mvvproject/ReVerSE-U8/u8_tsconf/readme.txt

-------------------------------------------------------------------------------
U8-TSConf
DEVBOARD ReVerSE-U8 By MVV
-------------------------------------------------------------------------------
27.07.2014	первая версия
03.07.2014	перенос с ReVerSE-U16
05.07.2014	доработка keyboard.vhd для работы с WC, I2S, Mouse
09.09.2014	добавлена поддержка IDE Video DAC (3:3:3) (zports.v, video_out.v, lut.vhd)
21.09.2014	tv80s вместо t80 (биения бордюрных эффектов)
25.07.2015	в загрузчике добавлена загрузка ROMS/ZXEVO.ROM с SD Card FAT32
04.10.2015	доработка sdram.vhd для U8 (автор shurik-ua)
29.01.2017	добавлена SAA1099, замена YM2149
