mvvproject/ReVerSE-U8/u8_board/images/u8_bot01.jpg

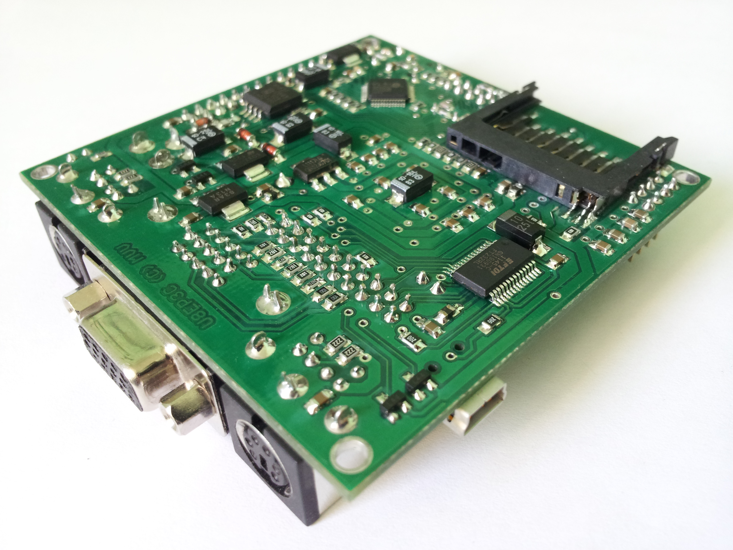
u8_board/images/u8_bot01.jpg
