mvvproject/ReVerSE-U8/u8_board/images/u8_top01.jpg

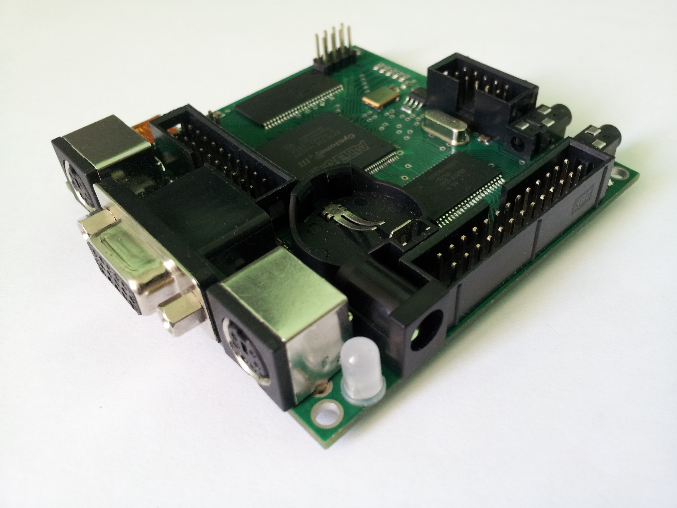
u8_board/images/u8_top01.jpg
