mvvproject/ReVerSE-U8/(list of files, cad)

Other CAD files:
u8_speccy/boards/reverse_u9/syn/stp1.stp
