mvvproject/ReVerSE-U8/u8_tsconf/rtl/gs/gs.vhd

-------------------------------------------------------------------[04.10.2015]
-- General Sound
-------------------------------------------------------------------------------
-- 01.11.2011	первая версия
-- 19.12.2011	CPU @ 84MHz, подтверждение INT#
-- 10.05.2013	исправлен bit7_flag, bit0_flag
-- 29.05.2013	добавлена громкость каналов, CPU @ 21MHz
-- 21.07.2013	исправлен int_n

-- CPU: Z80
-- ROM: 32K
-- RAM: 480K
-- INT: 37.5KHz

-- #xxBB Command register - регистр команд, доступный для записи
-- #xxBB Status register - регистр состояния, доступный для чтения
--		bit 7 флаг данных
--		bit <6:1> Не определен
--		bit 0 флаг команд. Этот регистр позволяет определить состояние GS, в частности можно ли прочитать или записать очередной байт данных, или подать очередную команду, и т.п.
-- #xxB3 Data register - регистр данных, доступный для записи. В этот регистр Спектрум записывает данные, например, это могут быть аргументы команд.
-- #xxB3 Output register - регистр вывода, доступный для чтения. Из этого регистра Спектрум читает данные, идущие от GS

-- Внутренние порта:
-- #xx00 "расширенная память" - регистр доступный для записи
--		bit <3:0> переключают страницы по 32Kb, страница 0 - ПЗУ
--		bit <7:0> не используются

-- порты 1 - 5 "обеспечивают связь с SPECTRUM'ом"
-- #xx01 чтение команды General Sound'ом
--		bit <7:0> код команды
-- #xx02 чтение данных General Sound'ом
--		bit <7:0> данные
-- #xx03 запись данных General Sound'ом для SPECTRUM'a
--		bit <7:0> данные
-- #xx04 чтение слова состояния General Sound'ом
--		bit 0 флаг команд
--		bit 7 флаг данных
-- #xx05 сбрасывает бит D0 (флаг команд) слова состояния

-- порты 6 - 9 "регулировка громкости" в каналах 1 - 4
-- #xx06 "регулировка громкости" в канале 1
--		bit <5:0> громкость
--		bit <7:6> не используются
-- #xx07 "регулировка громкости" в канале 2
--		bit <5:0> громкость
--		bit <7:6> не используются
-- #xx08 "регулировка громкости" в канале 3
--		bit <5:0> громкость
--		bit <7:6> не используются
-- #xx09 "регулировка громкости" в канале 4
--		bit <5:0> громкость
--		bit <7:6> не используются

-- #xx0A устанавливает бит 7 слова состояния не равным биту 0 порта #xx00
-- #xx0B устанавливает бит 0 слова состояния равным биту 5 порта #xx06

--Распределение памяти
--#0000 - #3FFF  -  первые 16Kb ПЗУ
--#4000 - #7FFF  -  первые 16Kb первой страницы ОЗУ
--#8000 - #FFFF  -  листаемые страницы по 32Kb
--                  страница 0  - ПЗУ,
--                  страница 1  - первая страница ОЗУ
--                  страницы 2... ОЗУ

--Данные в каналы заносятся при чтении процессором ОЗУ по адресам  #6000 - #7FFF автоматически.

library IEEE; 
use IEEE.std_logic_1164.all; 
use IEEE.std_logic_unsigned.all;
use IEEE.numeric_std.all;
use IEEE.STD_LOGIC_ARITH.all;

entity gs is
	Port ( 
		RESET		: in std_logic;
		CLK			: in std_logic;
		CLKGS		: in std_logic;
		A			: in std_logic_vector(15 downto 0);
		DI			: in std_logic_vector(7 downto 0);
		DO			: out std_logic_vector(7 downto 0);
		WR_n		: in std_logic;
		RD_n		: in std_logic;
		IORQ_n		: in std_logic;
		M1_n		: in std_logic;
		OUTA		: out std_logic_vector(13 downto 0);
		OUTB		: out std_logic_vector(13 downto 0);
		OUTC		: out std_logic_vector(13 downto 0);
		OUTD		: out std_logic_vector(13 downto 0);
		MA			: out std_logic_vector(18 downto 0);
		MDI			: in std_logic_vector(7 downto 0);
		MDO			: out std_logic_vector(7 downto 0);
		MWE_n		: out std_logic);
end gs;
 
architecture gs_unit of gs is
	signal port_xxbb_reg	: std_logic_vector(7 downto 0);
	signal port_xxb3_reg 	: std_logic_vector(7 downto 0);
	signal port_xx00_reg 	: std_logic_vector(7 downto 0);
	signal port_xx03_reg 	: std_logic_vector(7 downto 0);
	signal port_xx06_reg 	: std_logic_vector(5 downto 0);
	signal port_xx07_reg 	: std_logic_vector(5 downto 0);
	signal port_xx08_reg 	: std_logic_vector(5 downto 0);
	signal port_xx09_reg 	: std_logic_vector(5 downto 0);
	signal ch_a_reg 		: std_logic_vector(7 downto 0);
	signal ch_b_reg 		: std_logic_vector(7 downto 0);
	signal ch_c_reg 		: std_logic_vector(7 downto 0);
	signal ch_d_reg 		: std_logic_vector(7 downto 0);
	signal bit7_flag		: std_logic;
	signal bit0_flag		: std_logic;
	signal cnt				: std_logic_vector(9 downto 0);
	signal int_n			: std_logic;
	signal mem				: std_logic_vector(4 downto 0);
	signal out_a			: std_logic_vector(13 downto 0);
	signal out_b			: std_logic_vector(13 downto 0);
	signal out_c			: std_logic_vector(13 downto 0);
	signal out_d			: std_logic_vector(13 downto 0);
	
	-- CPU
	signal cpu_m1_n			: std_logic;
	signal cpu_mreq_n		: std_logic;
	signal cpu_iorq_n		: std_logic;
	signal cpu_rd_n			: std_logic;
	signal cpu_wr_n			: std_logic;
	signal cpu_a_bus		: std_logic_vector(15 downto 0);
	signal cpu_di_bus		: std_logic_vector(7 downto 0);
	signal cpu_do_bus		: std_logic_vector(7 downto 0);

begin

z80_unit: entity work.T80s
generic map (
	Mode			=> 0,	-- 0 => Z80, 1 => Fast Z80, 2 => 8080, 3 => GB
	T2Write			=> 1,	-- 0 => WR_n active in T3, 1 => WR_n active in T2
	IOWait			=> 1)	-- 0 => Single cycle I/O, 1 => Std I/O cycle
port map (
	RESET_n			=> not RESET,
	CLK_n			=> not CLKGS,
	WAIT_n			=> '1',
	INT_n			=> int_n,
	NMI_n			=> '1',
	BUSRQ_n			=> '1',
	M1_n			=> cpu_m1_n,
	MREQ_n			=> cpu_mreq_n,
	IORQ_n			=> cpu_iorq_n,
	RD_n			=> cpu_rd_n,
	WR_n			=> cpu_wr_n,
	RFSH_n			=> open,
	HALT_n			=> open,
	BUSAK_n			=> open,
	A			=> cpu_a_bus,
	DI			=> cpu_di_bus,
	DO			=> cpu_do_bus,
	SavePC      		=> open,
	SaveINT     		=> open,
	RestorePC   		=> (others => '1'),
	RestoreINT  		=> (others => '1'),
	RestorePC_n 		=> '1');

	
process (CLKGS, cnt)
begin
	if CLKGS'event and CLKGS = '1' then
		cnt <= cnt + 1;
		if cnt = "1000110000" then	-- 21MHz / 560 = 0.0375MHz = 37.5kHz
			cnt <= (others => '0');
		end if;
	end if;
end process;

-- INT#
process (CLKGS, cpu_iorq_n, cpu_m1_n, cnt)
begin
	if cpu_iorq_n = '0' and cpu_m1_n = '0' then
		int_n <= '1';
	elsif CLKGS'event and CLKGS = '1' then
		if cnt = "1000110000" then
			int_n <= '0';
		end if;
	end if;
end process;

process (CLKGS, cpu_iorq_n, cpu_m1_n, cpu_a_bus, IORQ_n, RD_n, A, WR_n)
begin
	if (cpu_iorq_n = '0' and cpu_m1_n = '1' and cpu_a_bus(3 downto 0) = X"2") or (IORQ_n = '0' and RD_n = '0' and A(7 downto 0) = X"B3") then
		bit7_flag <= '0';
	elsif (cpu_iorq_n = '0' and cpu_m1_n = '1' and cpu_a_bus(3 downto 0) = X"3") or (IORQ_n = '0' and WR_n = '0' and A(7 downto 0) = X"B3") then
		bit7_flag <= '1';
	elsif CLKGS'event and CLKGS = '1' then
		if (cpu_iorq_n = '0' and cpu_m1_n = '1' and cpu_a_bus(3 downto 0) = X"A") then
			bit7_flag <= not port_xx00_reg(0);
		end if;
	end if;
end process;

process (CLKGS, cpu_iorq_n, cpu_m1_n, cpu_a_bus, IORQ_n, RD_n, A, WR_n)
begin
	if cpu_iorq_n = '0' and cpu_m1_n = '1' and cpu_a_bus(3 downto 0) = X"5" then
		bit0_flag <= '0';
	elsif IORQ_n = '0' and WR_n = '0' and A(7 downto 0) = X"BB" then
		bit0_flag <= '1';
	elsif CLKGS'event and CLKGS = '1' then
		if (cpu_iorq_n = '0' and cpu_m1_n = '1' and cpu_a_bus(3 downto 0) = X"B") then
			bit0_flag <= port_xx06_reg(5);
		end if;
	end if;
end process;

process (CLK, A, IORQ_n, WR_n, RESET)
begin
	-- запись со стороны спектрума
 	if RESET = '1' then
		port_xxbb_reg <= (others => '0');
		port_xxb3_reg <= (others => '0');
	elsif CLK'event and CLK = '1' then
		if IORQ_n = '0' and WR_n = '0' and A(7 downto 0) = X"BB" then port_xxbb_reg <= DI; end if;
		if IORQ_n = '0' and WR_n = '0' and A(7 downto 0) = X"B3" then port_xxb3_reg <= DI; end if;
	end if;
end process;

process (A, bit7_flag, bit0_flag, port_xx03_reg)
begin	
	-- чтение со стороны спектрума
	if A(3) = '1' then	-- port #xxBB
		DO <= bit7_flag & "111111" & bit0_flag;
	else				-- port #xxB3
		DO <= port_xx03_reg;
	end if;
end process;

process (CLKGS, RESET, cpu_a_bus, cpu_m1_n, port_xx00_reg)
begin
	if RESET = '1' then
		port_xx00_reg <= (others => '0');
        port_xx03_reg <= (others => '0');
        port_xx06_reg <= (others => '0');
        port_xx07_reg <= (others => '0');
        port_xx08_reg <= (others => '0');
        port_xx09_reg <= (others => '0');
		ch_a_reg <= (others => '0');
		ch_b_reg <= (others => '0');
		ch_c_reg <= (others => '0');
		ch_d_reg <= (others => '0');
		
	elsif CLKGS'event and CLKGS = '1' then
		if cpu_iorq_n = '0' and cpu_wr_n = '0' and cpu_a_bus(3 downto 0) = X"0" then port_xx00_reg <= cpu_do_bus; end if;
		if cpu_iorq_n = '0' and cpu_wr_n = '0' and cpu_a_bus(3 downto 0) = X"3" then port_xx03_reg <= cpu_do_bus; end if;
		if cpu_iorq_n = '0' and cpu_wr_n = '0' and cpu_a_bus(3 downto 0) = X"6" then port_xx06_reg <= cpu_do_bus(5 downto 0); end if;
		if cpu_iorq_n = '0' and cpu_wr_n = '0' and cpu_a_bus(3 downto 0) = X"7" then port_xx07_reg <= cpu_do_bus(5 downto 0); end if;
		if cpu_iorq_n = '0' and cpu_wr_n = '0' and cpu_a_bus(3 downto 0) = X"8" then port_xx08_reg <= cpu_do_bus(5 downto 0); end if;
		if cpu_iorq_n = '0' and cpu_wr_n = '0' and cpu_a_bus(3 downto 0) = X"9" then port_xx09_reg <= cpu_do_bus(5 downto 0); end if;
		
		if cpu_mreq_n = '0' and cpu_rd_n = '0' and cpu_a_bus(15 downto 13) = "011" and cpu_a_bus(9 downto 8) = "00" then ch_a_reg <= MDI; end if;
		if cpu_mreq_n = '0' and cpu_rd_n = '0' and cpu_a_bus(15 downto 13) = "011" and cpu_a_bus(9 downto 8) = "01" then ch_b_reg <= MDI; end if;
		if cpu_mreq_n = '0' and cpu_rd_n = '0' and cpu_a_bus(15 downto 13) = "011" and cpu_a_bus(9 downto 8) = "10" then ch_c_reg <= MDI; end if;
		if cpu_mreq_n = '0' and cpu_rd_n = '0' and cpu_a_bus(15 downto 13) = "011" and cpu_a_bus(9 downto 8) = "11" then ch_d_reg <= MDI; end if;
	end if;

	case cpu_a_bus(15 downto 14) is
		when "00" => mem <= "00000";										--#0000 - #3FFF  -  первые 16Kb ПЗУ
		when "01" => mem <= "00010";										--#4000 - #7FFF  -  первые 16Kb первой страницы ОЗУ
		when others => mem <= port_xx00_reg(3 downto 0) & cpu_a_bus(14);	--#8000 - #FFFF  -  листаемые страницы по 32Kb
	end case;
end process;

-- Шина данных CPU
cpu_di_bus <=	MDI when (cpu_mreq_n = '0' and cpu_rd_n = '0') else
				bit7_flag & "111111" & bit0_flag when (cpu_iorq_n = '0' and cpu_rd_n = '0' and cpu_a_bus(3 downto 0) = X"4") else
				port_xxbb_reg when (cpu_iorq_n = '0' and cpu_rd_n = '0' and cpu_a_bus(3 downto 0) = X"1") else
				port_xxb3_reg when (cpu_iorq_n = '0' and cpu_rd_n = '0' and cpu_a_bus(3 downto 0) = X"2") else
				"11111111";

OUTA 	<= ch_a_reg * port_xx06_reg;
OUTB 	<= ch_b_reg * port_xx07_reg;
OUTC 	<= ch_c_reg * port_xx08_reg;
OUTD 	<= ch_d_reg * port_xx09_reg;
MA		<= mem & cpu_a_bus(13 downto 0);
MDO 	<= cpu_do_bus;
MWE_n 	<= cpu_wr_n or cpu_mreq_n or not (mem(4) or mem(3) or mem(2) or mem(1));

end gs_unit;
