mvvproject/ReVerSE-U8/u8_msx/src/DE0/SEG7_LUT.V

//Legal Notice: (C)2006 Altera Corporation. All rights reserved. Your
//use of Altera Corporation's design tools, logic functions and other
//software and tools, and its AMPP partner logic functions, and any
//output files any of the foregoing (including device programming or
//simulation files), and any associated documentation or information are
//expressly subject to the terms and conditions of the Altera Program
//License Subscription Agreement or other applicable license agreement,
//including, without limitation, that your use is for the sole purpose
//of programming logic devices manufactured by Altera and sold by Altera
//or its authorized distributors.  Please refer to the applicable
//agreement for further details.

module SEG7_LUT	(oSEG,iDIG);
input	[3:0]	iDIG;
output	[6:0]	oSEG;
reg	[6:0]	oSEG;

always @(iDIG)
begin
		case(iDIG)
		4'h1: oSEG = 7'b1111001;	// ---t----
		4'h2: oSEG = 7'b0100100; 	// |	  |
		4'h3: oSEG = 7'b0110000; 	// lt	 rt
		4'h4: oSEG = 7'b0011001; 	// |	  |
		4'h5: oSEG = 7'b0010010; 	// ---m----
		4'h6: oSEG = 7'b0000010; 	// |	  |
		4'h7: oSEG = 7'b1111000; 	// lb	 rb
		4'h8: oSEG = 7'b0000000; 	// |	  |
		4'h9: oSEG = 7'b0011000; 	// ---b----
		4'ha: oSEG = 7'b0001000;
		4'hb: oSEG = 7'b0000011;
		4'hc: oSEG = 7'b1000110;
		4'hd: oSEG = 7'b0100001;
		4'he: oSEG = 7'b0000110;
		4'hf: oSEG = 7'b0001110;
		4'h0: oSEG = 7'b1000000;
		endcase
end

endmodule
