mvvproject/ReVerSE-U8/u8_tsconf/rtl/ts/cpu/zint.v

module zint
(
	input  wire clk,
	input  wire zpos,
	input  wire res,
	input  wire int_start_frm,
	input  wire int_start_lin,
	input  wire int_start_dma,
	input  wire vdos,
	input  wire intack,
	input wire  [7:0] intmask,
	output wire [7:0] im2vect,
	
	output wire int_n
);

	// In VDOS INTs are focibly disabled.
	// For Frame, Line INT its generation is blocked, it will be lost.
	// For DMA INT only its output is blocked, so DMA ISR will will be processed as soon as returned from VDOS.
	
	assign im2vect = {vect[int_sel]};

	wire [7:0] vect [0:3];
	assign vect[INTFRM] = 8'hFF;
	assign vect[INTLIN] = 8'hFD;
	assign vect[INTDMA] = 8'hFB;
	assign vect[INTDUM] = 8'hFF;

	assign int_n = int_all ? 1'b0 : 1'b1;
	wire int_all = (int_frm || int_lin || int_dma) && !vdos;
		
	//===========================================================
	wire dis_int_frm = !intmask[0];
	wire dis_int_lin = !intmask[1];
	wire dis_int_dma = !intmask[2];
	
	// ~INT source latch
	wire intack_s = intack && !intack_r;
	
	reg intack_r;
	always @(posedge clk)
		intack_r <= intack;
	
	localparam INTFRM = 2'b00;
	localparam INTLIN = 2'b01;
	localparam INTDMA = 2'b10;
	localparam INTDUM = 2'b11;
		
	reg [1:0] int_sel;
	always @(posedge clk)
		if (intack_s)
		begin
			if (int_frm)
				int_sel <= INTFRM;		// priority 0
			else if (int_lin)
				int_sel <= INTLIN;		// priority 1
			else if (int_dma)
				int_sel <= INTDMA;		// priority 2
		end

// ~INT generating
	reg int_frm;
	always @(posedge clk)
		if (res || dis_int_frm)
			int_frm <= 1'b0;
		else if (int_start_frm)
			int_frm <= 1'b1;
		else if (intctr_fin || intack_s)		// priority 0
			int_frm <= 1'b0;

	reg int_lin;
	always @(posedge clk)
		if (res || dis_int_lin)
			int_lin <= 1'b0;
		else if (int_start_lin)
			int_lin <= 1'b1;
		else if (intack_s && !int_frm)			// priority 1
			int_lin <= 1'b0;

	reg int_dma;
	always @(posedge clk)
		if (res || dis_int_dma)
			int_dma <= 1'b0;
		else if (int_start_dma)
			int_dma <= 1'b1;
		else if (intack_s && !int_frm && !int_lin)	// priority 2
			int_dma <= 1'b0;


// INT counter
//	reg [4:0] intctr;
//	wire intctr_fin = &intctr;    // 32 clks
// ~INT counter
	reg [5:0] intctr;
	wire intctr_fin = intctr[5];   // 32 clks

	
//	always @(posedge zclk, posedge int_start_lin)
	always @(posedge clk, posedge int_start_frm)
	begin
//		if (int_start_lin)
		if (int_start_frm)
			intctr <= 6'b000000;
		else if (zpos && !intctr_fin && !vdos)
			intctr <= intctr + 6'b000001;
	end
			
endmodule
